ssserghei/xiao-wio-18650-tube-case/docs/images/battery_contacts.png

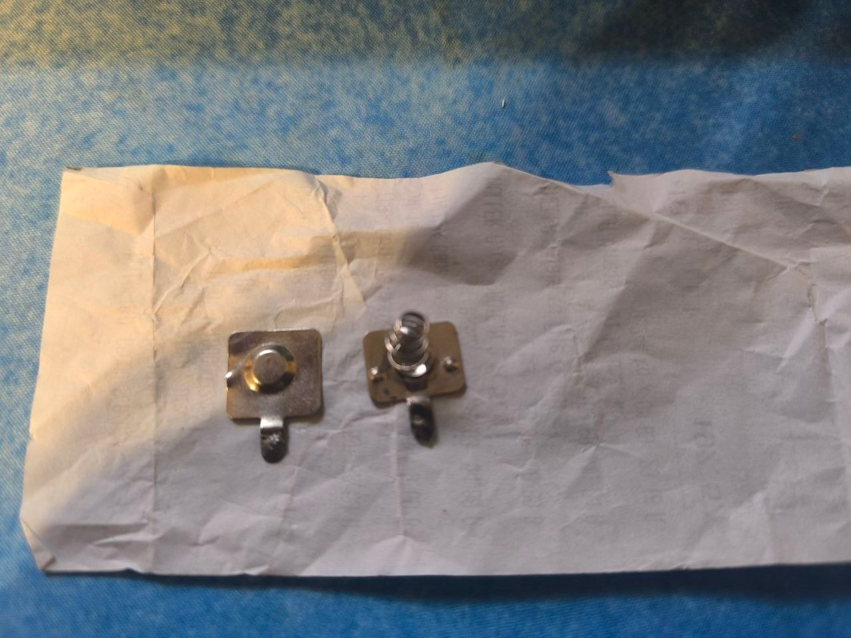
docs/images/battery_contacts.png
