ssserghei/xiao-wio-18650-tube-case/renders/rear_boards.png

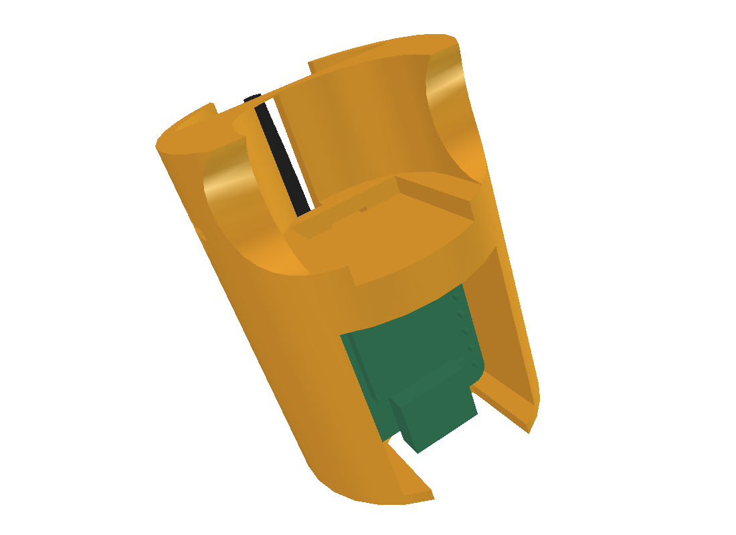
renders/rear_boards.png
