ssserghei/xiao-wio-18650-tube-case/renders/rear_boards_under.png

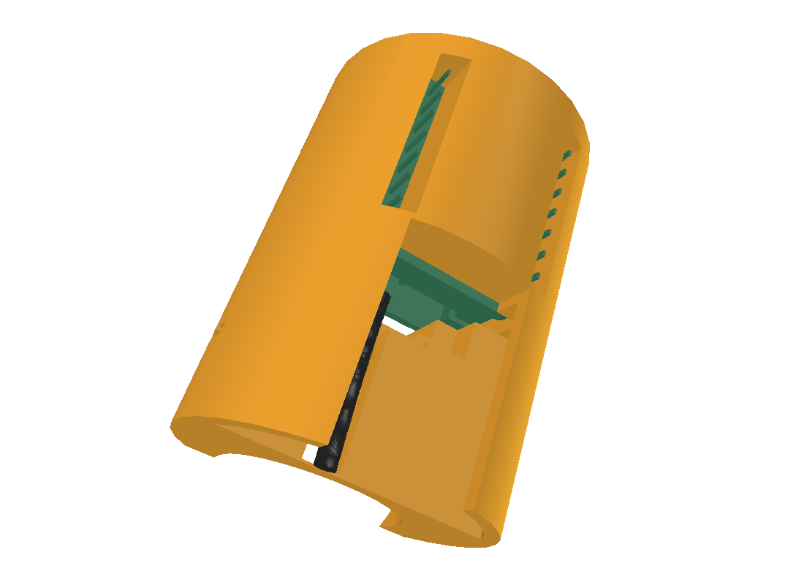
renders/rear_boards_under.png
