ssserghei/xiao-wio-18650-tube-case/renders/rear_iso_bottom.png

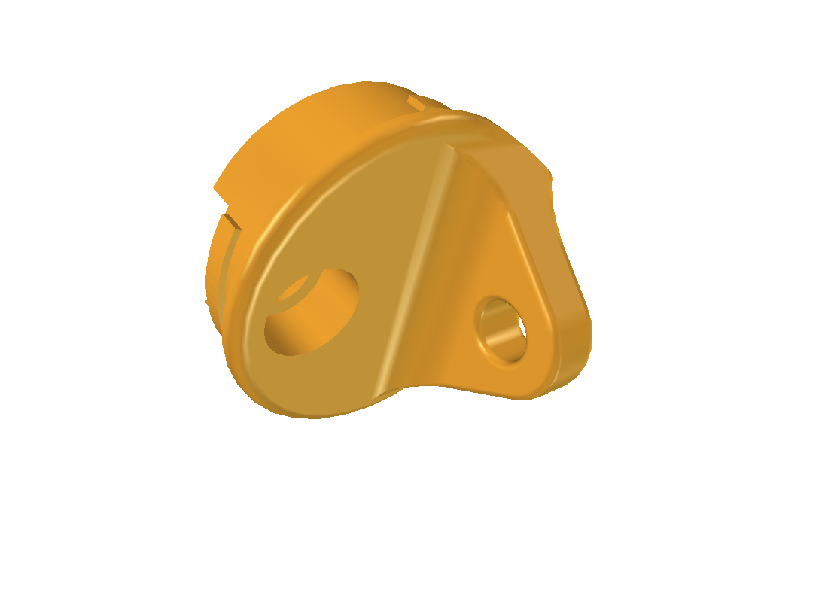
renders/rear_iso_bottom.png
