ssserghei/xiao-wio-18650-tube-case/renders/rear_rear.png

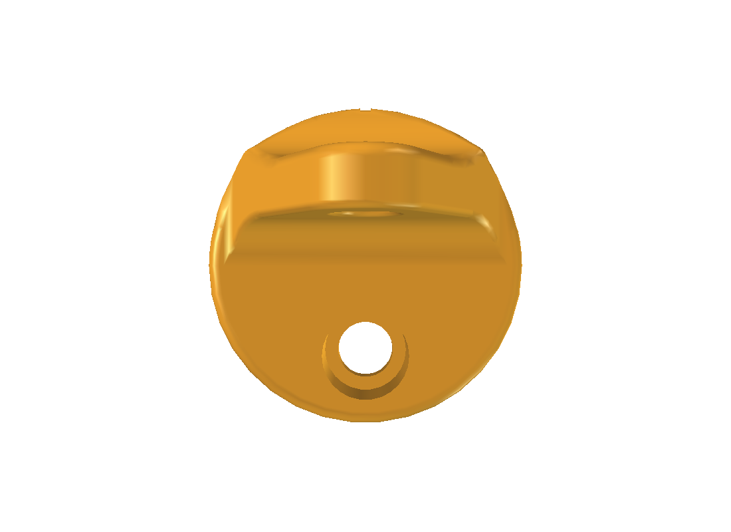
renders/rear_rear.png
