ssserghei/xiao-wio-18650-tube-case/renders/rear_side.png

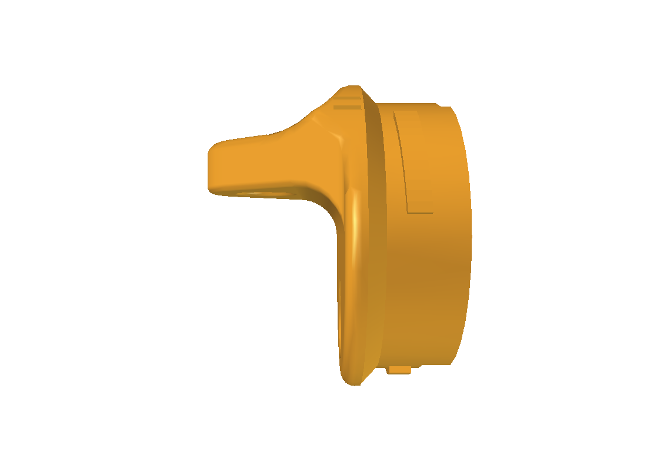
renders/rear_side.png
