ssserghei/xiao-wio-18650-tube-case/cad/xiao_wio_18650_tube_case.FCStd

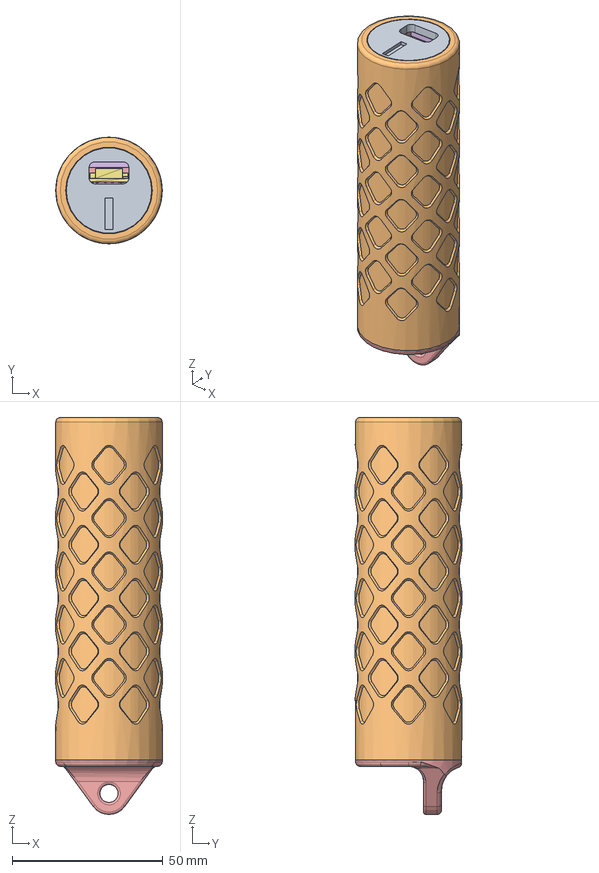
[picture p25: CAD file, 2026-11-11]
cad/xiao_wio_18650_tube_case.FCStd
35.4 x 35.4 x 131.9 mm
Battery
NegativeContact
PositiveContact
SpringEnvelope
ChassisFinal
BoardClamp
BoardStackModel
AntennaCable
Shutter
SleeveFinal
BatteryButton
