ssserghei/xiao-wio-18650-tube-case/reference/xiao-nrf52840-and-wio-sx1262.stl

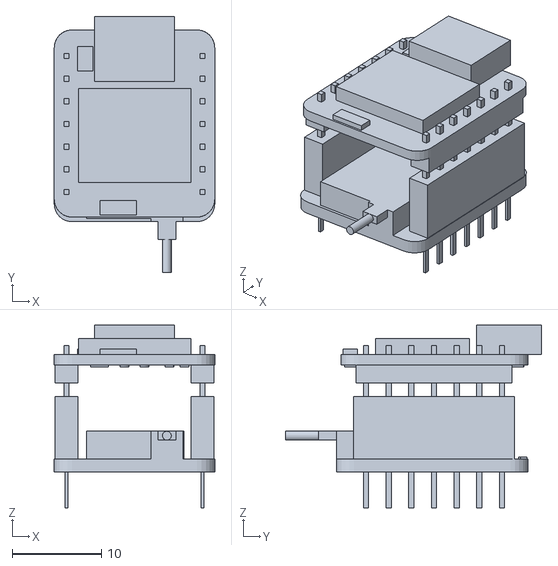
[picture p26: CAD file, 2026-11-07]
reference/xiao-nrf52840-and-wio-sx1262.stl
18.0 x 28.7 x 20.5
