ssserghei/xiao-wio-18650-tube-case/stl/xiao_wio_18650_tube_case_chassis.stl

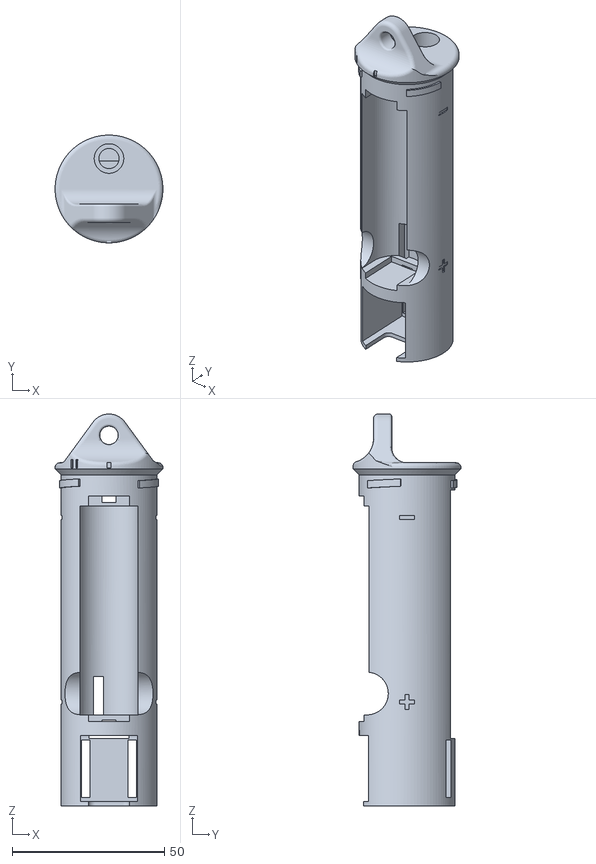
[picture p27: CAD file, 2026-11-11]
stl/xiao_wio_18650_tube_case_chassis.stl
35.4 x 35.4 x 128.7
