ssserghei/xiao-wio-18650-tube-case/stl/xiao_wio_18650_tube_case_sleeve.stl

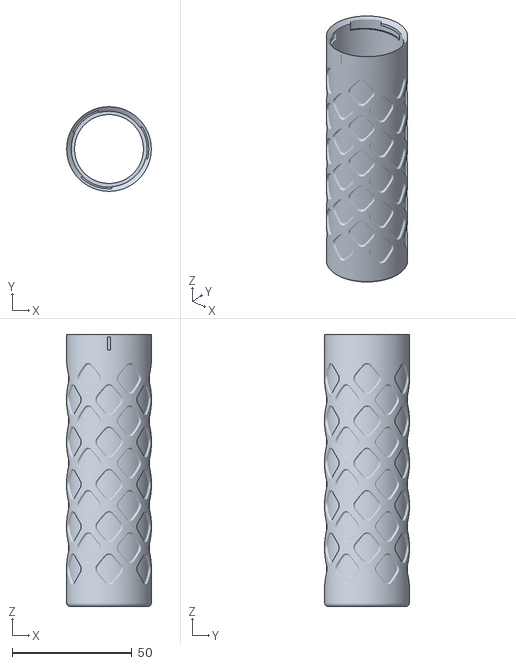
[picture p28: CAD file, 2026-11-11]
stl/xiao_wio_18650_tube_case_sleeve.stl
35.4 x 35.4 x 113.8
