ssserghei/xiao-wio-18650-tube-case/stl/xiao_wio_18650_tube_case_board_clamp.stl

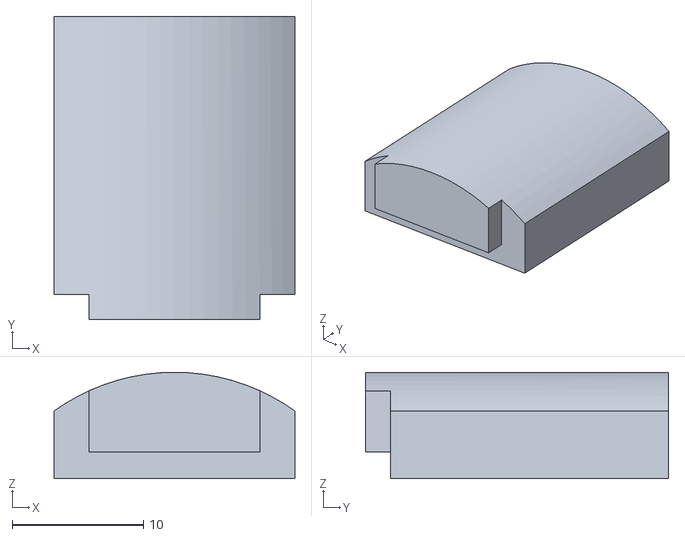
[picture p29: CAD file, 2026-11-10]
stl/xiao_wio_18650_tube_case_board_clamp.stl
18.3 x 23.0 x 8.10
