ssserghei/xiao-wio-18650-tube-case/stl/xiao_wio_18650_tube_case_shutter.stl

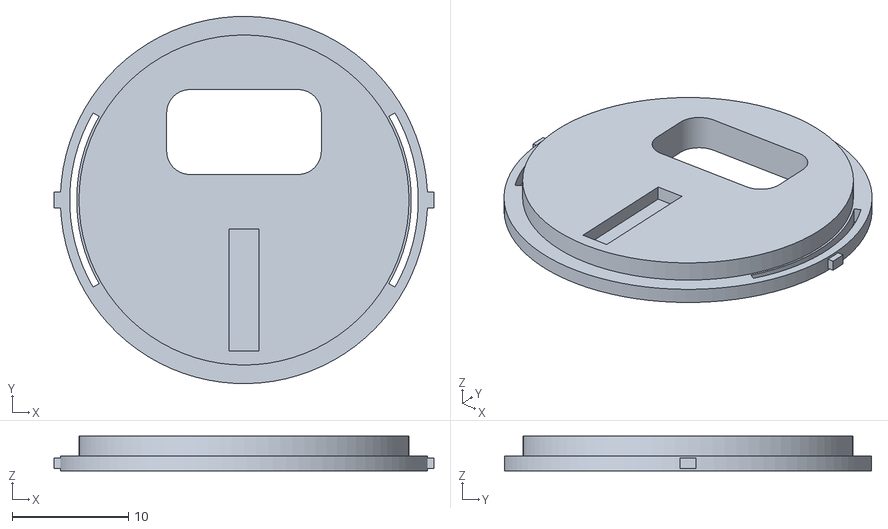
[picture p30: CAD file, 2026-11-10]
stl/xiao_wio_18650_tube_case_shutter.stl
32.7 x 31.6 x 3.00
