ssserghei/xiao-wio-18650-tube-case/TODO.md

# TODO

Changes planned after the first test print. See also *Things to check on the first print* in the [README](README.md).

## Other open items

- Print 3: check the shutter detents click, a reversed cell does not touch the plus plate, the USB-C plug seats fully, and the internal bridges of the standing chassis.
- Belt or backpack clip mount: on hold. Options: M3 pad under the flange, 25 mm strap loop on the flange, separate snap-on clip around the sleeve.
- Smaller diameter (about 32 mm): on hold, to discuss.
