ssserghei/xiao-wio-18650-tube-case/docs/design-log-ru.md

# Корпус XIAO + Wio: инструкция FreeCAD

**Сейчас: этап 35 — пробная печать и примерка.** Рабочий документ: `cad/xiao_wio_18650_tube_case.FCStd`; его правит Claude скриптами, `designs/xiao_wio_case/xiao_wio_case.FCStd` остаётся базой. Этапы 28–34 выполнены, этап 27 отменён. Интерфейс: FreeCAD 1.1.3, английский.
Вопросы задавай по номеру шага. Даём несколько этапов сразу; пояснения держим компактными.

## Дорожная карта до первого готового корпуса

| Этап | Результат |
| --- | --- |
| 25 | Размер и положение USB-C. |
| 26 | Проём USB-C в передней части шасси. |
| 27 | Отменён: выключателя нет, вставленная батарея сразу питает устройство. |
| 28 | Батарея поднята, проходы контактов, паз проводов снизу. Выполнен. |
| 29 | Подъём проводов к платам, отверстие антенного разъёма. Выполнен. |
| 30 | Поворотная шторка USB-C и окно под штекер. Выполнен. |
| 31 | Канавка кольца, ключ шасси — гильза, заход кольца. Выполнен. |
| 32 | Прижимная вставка плат. Выполнен. |
| 33 | Скруглённая проушина, отвод антенного кабеля, модель блока плат. Выполнен. Остальные скругления — после примерки. |
| 34 | STL всех деталей, проверка сетки и нарезка в PrusaSlicer. Выполнен. |
| 35 | Тестовая печать и примерка батареи, контактов, плат, антенны. |
| 36 | Корректировка размеров, финальный STL и печать корпуса. |

Ничего необратимого нет: после пробной примерки размеры можно спокойно менять в `Parameters`.

## Этап 22. Первый прототип держателей контактов

Цель простая: контактные пластины должны лежать на торцах батареи, а пружина — давить на аккумулятор. Сейчас не делаем точную фиксацию мелких выступов. Для первого прототипа оставим пластинам небольшой карман и проверим посадку физически.

- **22.1.** Больше ничего измерять сейчас не нужно. Уже известных размеров достаточно: пластины шириной 13 мм, минусовая — 10 мм высотой, плюсовая — 12,1 мм.
- **22.2.** Нажми **Ctrl+S**. На следующем шаге создадим по одному простому пазу под каждую пластину. Фиксирующие выступы и ушки добавим после первой примерки.

## Этап 23. Зазор для простых пазов

Пазы будут открыты в сторону большого бокового окна: пластину можно вставить до установки шасси в гильзу. Гильза закроет эти отверстия снаружи.

- **23.1.** В `Parameters` добавь три строки. Подпись — в A, значение — в B, alias назначь ячейке B.

| Строка | Подпись в A | Значение в B | Alias |
| --- | --- | --- | --- |
| 44 | Зазор паза контакта | `0.2 mm` | `ContactPocketClearance` |
| 45 | Глубина минусового паза | `=NegativePlateEnvelope + ContactPocketClearance` | `NegativePocketDepth` |
| 46 | Глубина плюсового паза | `=PositivePlateThickness + 2 * ContactPocketClearance` | `PositivePocketDepth` |

- **23.2.** Проверь: B45 = **1,1 мм**, B46 = **0,75 мм**. **Ctrl+S**.

## Этап 24. Вырезать два простых паза

- **24.1.** В 3D-виде оставь видимым `ChassisSpring`. Покажи `NegativeContact` и `PositiveContact`; им поставь **View → Transparency = 70**, чтобы видеть совпадение с пазами.
- **24.2.** Создай **Part → Primitives → Cube** → `NegativePocketTool`. Введи:

| Свойство | Выражение |
| --- | --- |
| Length | `<<Parameters>>.ContactPlateWidth + 2 * <<Parameters>>.ContactPocketClearance` |
| Width | `<<Parameters>>.ChassisDiameter / 2 + <<Parameters>>.NegativePlateHeight / 2 + <<Parameters>>.ContactPocketClearance + 1 mm` |
| Height | `<<Parameters>>.NegativePocketDepth` |
| Position x | `-(<<Parameters>>.ContactPlateWidth / 2 + <<Parameters>>.ContactPocketClearance)` |
| Position y | `-(<<Parameters>>.NegativePlateHeight / 2 + <<Parameters>>.ContactPocketClearance)` |
| Position z | `<<Parameters>>.NegativeContactZ - <<Parameters>>.NegativePocketDepth` |

- **24.3.** Выдели сначала `ChassisSpring`, затем с Ctrl `NegativePocketTool` → **Part → Boolean → Cut**. Назови результат `ChassisNegativePocket`.
- **24.4.** Создай второй **Cube** → `PositivePocketTool`. Введи:

| Свойство | Выражение |
| --- | --- |
| Length | `<<Parameters>>.ContactPlateWidth + 2 * <<Parameters>>.ContactPocketClearance` |
| Width | `<<Parameters>>.ChassisDiameter / 2 + <<Parameters>>.PositivePlateHeight / 2 + <<Parameters>>.ContactPocketClearance + 1 mm` |
| Height | `<<Parameters>>.PositivePocketDepth` |
| Position x | `-(<<Parameters>>.ContactPlateWidth / 2 + <<Parameters>>.ContactPocketClearance)` |
| Position y | `-(<<Parameters>>.PositivePlateHeight / 2 + <<Parameters>>.ContactPocketClearance)` |
| Position z | `<<Parameters>>.PositiveContactZ` |

- **24.5.** Выдели сначала `ChassisNegativePocket`, затем с Ctrl `PositivePocketTool` → **Part → Boolean → Cut**. Назови результат `ChassisContacts`.
- **24.6.** Выдели `ChassisContacts` → **Part → Check geometry → Run check**. Ожидаем **Solids = 1** и отсутствие ошибок. Временно поставь ему **Transparency = 80**: обе пластины должны лежать в пазах. **Ctrl+S**.

Пазы снаружи будут видны только до вставки шасси в гильзу. На первой примерке проверим, удерживает ли батарея пластины достаточно надёжно; тогда решим, нужны ли защёлки.

## Этап 25. Положение USB-C

Цель: получить три размера, чтобы сделать проём точно напротив разъёма. В FreeCAD пока ничего не меняем.

- **25.1.** Измерь ширину и высоту металлического USB-C разъёма.
- **25.2.** Измерь расстояние от центра USB-C до ближайшего края блока плат по вертикали.
- **25.3.** Пришли три значения в таком виде:

```text
USB-C: ширина … мм; высота … мм
Центр USB-C от ближайшего края блока плат: … мм
```

После этого сделаем прямоугольный проём с печатным зазором и привяжем к нему шторку.

## Этап 26. Макет проёма USB-C

Сначала ставим куб, который покажет будущую дырку. Его пока **не вырезаем**: `Electronics` — только габаритный блок, без точной формы разъёма.

**Ориентация зафиксирована:** сторона `+Y` — верх и сторона вставки «бутерброда» плат. USB-C выходит сюда же через открытый паз. Сторона `-Y` — низ: под батареей пойдёт антенный кабель.

- **26.1.** Перейди в **Part**. Скрой `Sleeve` и `ChassisContacts`. Покажи `Electronics`. Создай **Part → Primitives → Cube**, назови `USBWindowTool`.
- **26.2.** Во вкладке **Data** задай:

| Свойство | Значение |
| --- | --- |
| Length | `10 mm` |
| Width | `4.3 mm` |
| Height | `6 mm` |
| Position x | `-5 mm` |
| Position y | `<<Parameters>>.BoardThickness / 2 - 3.8 mm` |
| Position z | `<<Parameters>>.SleeveLength - <<Parameters>>.FrontSpace - 1 mm` |

10 × 4,3 мм — USB-C 9 × 3,3 мм плюс по 0,5 мм на сторону для печати. Куб должен лежать у верхнего края переднего торца блока плат; его ось совпадает с центром USB-C: 1,65 мм ниже верхней поверхности платы.

- **26.3.** Поставь `USBWindowTool` **View → Shape color** в яркий цвет и `Transparency = 40`. Нажми **0**, затем поверни модель к USB-торцу. Куб должен выходить за передний торец `Electronics` и находиться у его верхнего края.
- **26.4.** Скрой `Electronics`. Покажи `ChassisContacts`; `Sleeve` можно показать с прозрачностью 80. Выдели сначала `ChassisContacts`, затем с Ctrl `USBWindowTool` → **Part → Boolean → Cut**. Результат назови `ChassisUSB`.
- **26.5.** Выдели `ChassisUSB` → **Part → Check geometry → Run check**. Ожидаем `Solids = 1` и без ошибок. Покажи `Electronics`: USB-торец должен быть виден через новое отверстие. **Ctrl+S**.
- **26.6.** Проём должен быть открыт до верхнего края шасси, иначе «бутерброд» плат не вставится. Раскрой `ChassisUSB` в дереве и покажи `USBWindowTool` только для ориентира. Создай второй **Part → Primitives → Cube** → `USBEntryTool`.
- **26.7.** У `USBEntryTool` задай:

| Свойство | Значение |
| --- | --- |
| Length | `10 mm` |
| Width | `<<Parameters>>.ChassisDiameter / 2 - <<Parameters>>.BoardThickness / 2 + 1 mm` |
| Height | `6 mm` |
| Position x | `-5 mm` |
| Position y | `<<Parameters>>.BoardThickness / 2` |
| Position z | `<<Parameters>>.SleeveLength - <<Parameters>>.FrontSpace - 1 mm` |

Этот куб соединяет отверстие USB-C с верхним внешним краем. При текущих размерах его ширина будет **6,2 мм**.
- **26.8.** Выдели сначала `ChassisUSB`, затем с Ctrl `USBEntryTool` → **Part → Boolean → Cut**. Назови результат `ChassisUSBSlot`.
- **26.9.** Проверь `ChassisUSBSlot` через **Part → Check geometry**: `Solids = 1`, без ошибок. С USB-торца должен получиться открытый П-образный паз. **Ctrl+S**.

## Этап 35. Пробная печать и примерка

Детали лежат в `stl/`, уже в положении для печати; G-code для пробной печати — в `gcode/`. После правок модели оба набора устаревают. Настройки экспорта: FreeCAD 1.1.3, LinearDeflection 0,02 мм, AngularDeflection 10°, для шасси 0,05 мм и 12°, скрипт `scripts/export_stl.py`.

| Файл | Положение | Поддержки |
| --- | --- | --- |
| `xiao_wio_case_v2_chassis.stl` | лёжа, окном вверх: пазы контактов становятся вертикальными стенками | нужны, только от стола |
| `xiao_wio_case_v2_sleeve.stl` | стоя, бортиком на столе: нет свесов, отверстие круглое | не нужны |
| `xiao_wio_case_v2_board_clamp.stl` | плоской стороной на столе | не нужны, короткий свес у языка |
| `xiao_wio_case_v2_shutter.stl` | фланцем на столе: лицом вниз фланец висит в воздухе | не нужны |

Нарезка: PrusaSlicer 2.9.6, Creality Ender-3, сопло 0,4 мм, слой 0,2 мм, Generic PETG (240/70 °C), у шасси и гильзы кайма 6 мм. Сетки `manifold = yes`. Всего около 67 г и 8 ч 20 мин. Послойно смотрели только отдельные слои. Сначала стоит напечатать вставку и шторку: они быстрые и сразу покажут зазоры.

**Сборка**

1. Припаяй провода к ушкам контактов, заведи ушки в колодцы вниз и приклей пластины к плоским стенкам.
2. Заведи антенный разъём из паза изнутри, гайку наверни снаружи в выемке грибка. Выемка Ø12 мм, глубина 3,5 мм: нужна торцевая головка на 8 мм.
3. Проложи провода и антенный кабель по пазу и через подъём к платам. Припаяй провода, подключи антенну.
4. Вставь блок плат сверху, разъём USB-C попадает в окно торца. Сверху положи прижимную вставку, её язык закрывает паз над USB-C.
5. Надень кольцо 29 × 1,5 мм на канавку у грибка, вставь батарею: устройство сразу включится.
6. Вставь диск в гильзу с заднего конца до бортика. Вставь шасси USB-концом вперёд, совмести выступы с пазами и поверни шасси на 40° по часовой стрелке, если смотреть со стороны антенны, до затяжки.
7. Диск поворачивается за прорезь на торце. Открыто: окно напротив порта. Закрыто: поворот на 180°.

**Что проверить на примерке**

- Антенна накручивается до конца: резьба 11 мм, стенка 5,4 мм, гайка принята 2 мм, свободно около 3,6 мм. Глубже выемку делать нельзя: она прорежет грибок.
- Байонет: усилие затяжки и самоотвинчивание, крепость выступов. Кольцо 29 × 1,5 мм, канавка Ø29,6 × 2 мм.
- Передний упор блока плат: при выдёргивании штекера блок держат вставка и концы прорезей под штыри.
- Пружина минуса при рабочей высоте 2 мм: не сжимается ли она до упора.
- Диск: не слишком ли туго идёт, держат ли фиксаторы.
- Прижим плат вставкой: зазор 0,1 мм рассчитан по габаритному блоку.
- Проход проводов и антенного кабеля через подъём и выход за платами. Кабель Ø2 мм идёт практически прямо, до батареи около 1,2 мм.
- Посадку Wio на дно отсека и штыри в прорезях: прорезь 1,6 мм, кончики штырей на 0,5 мм от гильзы.
- Крепость проушины и размер отверстия Ø6 мм под твой карабин или шнур.

## Этап 33. Проушина, отвод кабеля, блок плат — выполнен

Скрипты: `apply_rear_lug.py`, `apply_cable_exit.py`, `apply_board_model.py`, `apply_lower_boards.py`, `apply_open_cable_slot.py`. Проверка: `check_stage_29_32.py`. Снимки: `renders/sections.png` и `renders/rear_*.png`.

- **Проушина** по образцу фото с Printables: плоская, плавно вырастает из торца через вогнутые дуги R5 и R8, контур сужается к концу Ø13 мм. Отверстие Ø6 мм смещено на 0,5 мм от конца, стенка у конца 4 мм, вылет 16 мм, толщина 6 мм, `LugCenterY` = 8 мм. Вместо `RearFlange` и кольца теперь одно тело `RearBody`. Диаметр грибка у гильзы остался полным. Рёбра скруглены R1,5 и R0,8; несколько коротких кромок у основания проушины FreeCAD не скруглил.
- **Блок плат** `BoardStackModel` — модель «XIAO nRF52840 & Wio-SX1262 Kit 3D model», автор zuberio, Printables, лицензия CC0. Только макет, не печатается. Высота 20,5 мм подтвердила замер 21 мм. Блок стоит в отсеке без касаний. В модели штыри на 0,35 мм короче реальных и кабель на 0,4 мм ниже, поэтому проверка считает штыри и кабель по замерам.
- **Спуск блока плат.** Изгиб кабеля мог сдёрнуть U.FL, поэтому блок опущен на 3 мм, штыри не подрезаем. Замеры: штыри 4,35 мм под Wio, центр кабеля 4,5 мм над низом Wio. Кончики штырей стоят на `PinTipY` = −13,5 мм, внутри диаметра шасси, и гильзы не касаются. Wio лежит на поднятом дне отсека (`WioBottomY` = −9,15 мм), штыри входят в прорези `PinSlotTools`. Верх блока теперь `StackTopY` = 7,5 мм, центр USB-C 5,85 мм, вставка стала толще, 8,1 мм.
- **Отвод кабеля.** U.FL стоит на верхней стороне Wio у конца, противоположного USB-C, кабель смещён на 3,6 мм от оси и выходит на Y=−4,65 мм. `BoardGap` = 6 мм. `CableExitTool` открывает выход на всю ширину паза, `CableSlotTool` — сквозной вырез 3,6 мм в полу батарейного отсека на последних 15 мм: стенка там не нужна, батарея лежит на боках ложемента. `AntennaCable` — макет кабеля, минимальный радиус изгиба 58 мм, то есть кабель практически прямой. Клип на U.FL между платами стоит оставить: он защищает от тряски.
- **STL.** На углах скруглений сетка получала мелкие самопересечения; `export_stl.py` чинит их и не записывает файл, пока сетка не чиста.

## Этап 45. Тонкая гильза — выполнено

Скрипт: `scripts/apply_thin_sleeve.py`. Гильза третьей печати оказалась слишком жёсткой. Стенка под решёткой 0,9 мм (две линии) вместо 1,5: `SleeveOuterDiameter` 33,8. Рёбра те же 0,8 мм, диаметр по рёбрам 35,4 вместо 36,6, грибок уменьшен следом, скругления заднего тела пересобраны. Пазы байонета и фиксаторов шторки лежат в сплошных поясах, над ними около 1 мм. Оболочка решётки теперь заходит в стенку только на 0,1 мм, иначе она снова заполняла бы эти пазы. Объём гильзы 16,1 см³ вместо 23,5.

Паутина внутри гильзы на печати — холостые переезды сопла поперёк трубы между участками заливки у рёбер. В PrusaSlicer: *Avoid crossing perimeters*, 5 периметров (вся стенка — круги), шов сзади, температура 235.

## Этап 44. Передняя стенка вплотную к платам — выполнено

Скрипт: `scripts/apply_trim_front.py`. Платы кончаются на 1,5 мм раньше разъёма USB-C (`USBOverhang`), и перед ними оставалась пустая полоса. Стенка 1,5 мм теперь стоит в 0,15 мм от плат, разъём проходит сквозь окно USB в ней, его торец на 0,15 мм не доходит до наружной плоскости стенки. `FrontSpace` 0,3 мм вместо 1,8: корпус на 1,5 мм короче (общая длина 131,9 мм), штекер входит на 1,5 мм глубже. Тело прижима кончается перед стенкой. Новая болванка `USBConnector`; путь штекера в проверке начинается от её торца.

## Этап 43. Утопление плюса по измеренной батарее — выполнено

Скрипт: `scripts/apply_measured_button.py`. Выступ плюса у батареи 1,32 мм (полная длина минус длина без выступа). При утоплении 0,5 мм выступ упирался бы в пластину раньше, чем плечо батареи в торец отсека: батарея встала бы на 0,8 мм дальше, и пружина распрямилась бы до ~3,3 мм.

- Отсек кончается у плеча батареи с зазором 0,3 мм (`BatteryPocketEndZ`).
- Кнопка пластины стоит ровно там, куда приходит выступ: на 1,02 мм за торцом отсека (`PlusContactRecess` = `BatteryButtonHeight` − `BatteryEndClearance`). Перевёрнутая батарея не достаёт до пластины на 1,02 мм.
- Пружина сохраняет рабочую высоту 2,5 мм. `BoardGap` снова 6 мм, корпус на 0,5 мм короче, чем на этапе 41.
- Болванка батареи теперь тело плюс выступ `BatteryButton` Ø8×1,32.
- Если батарея другая, поменяй `BatteryButtonHeight` и запусти `rebuild_static.py`.

## Этап 42. Крупнее фиксаторы шторки — выполнено

Скрипт: `scripts/apply_bold_detents.py`. Шторка держится подпружиненной защёлкой: выступ на тонкой дуге диска заскакивает в паз гильзы. На первой печати пазы глубиной 0,25 мм вышли похожими на паутинку от сопла и были срезаны. Теперь паз 0,75 мм глубиной (`DiscNotchRadius` 16,75) и 3 мм шириной (`DiscNotchWidth`), выступ диска 0,35 мм над посадкой (`DiscRibRadius` 16,35), пружинящая прорезь за выступом 0,6 мм (`DiscArcInnerRadius` 14,4).

## Этап 41. Защита от переполюсовки, метки, крупная решётка, печать стоя — выполнено

Скрипты: `scripts/apply_guard_marks.py`, `scripts/rebuild_static.py`.

- **Защита от переполюсовки.** Кнопка плюсовой пластины утоплена на 0,5 мм (`PlusContactRecess`) за торцевой стенкой отсека. Перед пластиной открытое окно 13,4 мм, а торец батареи Ø18,6 шире: перевёрнутая батарея упирается плоским минусом в стенку по краям окна и до пластины не достаёт, а выступ плюса входит в окно. Первый вариант с кольцом и отверстием Ø10 оставлял за кольцом паз 0,4 мм, который не напечатать; заменён скриптом `scripts/apply_open_plus_window.py`. Работает только с аккумулятором с выступом на плюсе (button top). Если 0,5 мм окажется мало, поменяй `PlusContactRecess` и запусти `rebuild_static.py`. Пластину вклеиваешь на заднюю стенку, как раньше.
- **Пружина минуса.** Отсек сдвинут на 0,5 мм от минусовой пластины (`RearSpace` 10,5): рабочая высота пружины 2,5 мм вместо 2, пластина осталась на месте. Плюсовая пластина ушла на +1,3 мм (Z=81,33), `BoardGap` 6,5 мм. Корпус длиннее на 1 мм.
- **Выемка под палец** радиусом 7 мм у плюсового конца батарейного окна, до оси батареи.
- **Метки.** «+» и «−» глубиной 0,5 мм на обеих боковинах шасси у контактов. На грибке одна канавка — положение «закрыто», две канавки — положение, в котором гильза надевается и снимается. На заднем поясе гильзы — риска, которая встаёт против канавок.
- **Решётка.** 6 ромбов по окружности вместо 11, рёбра 3 мм у основания, стенки ячеек с уклоном 30° (`RibDraft`), углы со скруглением 2,5 мм (`RibCornerRadius`). Только целые ячейки, без обрезков у поясов. Ячеек 60 вместо 231, решётка строится быстрее.
- **Печать стоя.** Шасси печатается на торце USB-C. Нижняя сторона грибка стала конусом 45° глубиной 1,9 мм (`SeamConeDepth`), гильза получила ответную юбку. Внутренние торцы отсеков и пазы пластин печатаются мостами до ~21 мм.
- **Параметричность.** `rebuild_static.py` пересобирает байонет, решётку, кабель, метки и скругления заднего тела по таблице. Скругления по рёбрам в FreeCAD хранятся номерами рёбер, поэтому «живыми» они не бывают: после правки таблицы запускай этот скрипт.

## Этап 40. Выпуклые рёбра вместо рифления — выполнено

Скрипт: `scripts/apply_raised_ribs.py`. Канавки рифления убраны: они утоньшали стенку. Вместо них на гильзу надета наружная оболочка 0,8 мм с ромбовидными окнами; между окнами остаются рёбра под 45°, 11 ромбов по окружности (около 10 мм), рёбра шириной 2,4 мм. Сплошные пояса: задний Z=0–6 мм над пазами байонета, где стенка теперь около 1,65 мм вместо 0,85, и передний 5,2 мм у торца. Диаметр по рёбрам 36,6 мм, грибок увеличен до того же диаметра, скругления заднего тела пересобраны. Построение окнами занимает около 1,5 минут; вариант с пересекающимися винтовыми рёбрами шёл 16 минут и дал некорректное тело.

## Этап 39. Ромбическое рифление на гильзе — выполнено

Скрипт: `scripts/apply_knurl.py`. Два пояса по 10 мм: задний на Z=6–16 мм, сразу за пазами байонета (над ними стенка всего 0,85 мм), передний на 10 мм перед торцом шасси, до пазов фиксаторов диска. 24 ромба по окружности (шаг около 4,6 мм), канавки V-образные глубиной 0,5 мм под 45°, у ромбов плоская вершина 0,6 мм. Склоны под 45° печатаются стоя без поддержек. Канавки — статическая форма `KnurlTool` из 96 винтовых вырезов. Проверка с рифлением идёт около 10 минут.

## Этап 38. Прорези под штыри для разъёмов Dupont — выполнен

Скрипт: `scripts/apply_dupont_slots.py`. Прорези под нижними штырями Wio расширены с 1,6 до 2,75 мм (`PinSlotWidth`), чтобы на штыри можно было надеть корпуса Dupont. Длина выросла с 17,3 до 18,8 мм (`PinSlotLength`): семь корпусов по 2,54 мм занимают около 17,8 мм. Ограничение по высоте: от низа Wio до гильзы около 6,8 мм, стандартный корпус Dupont (около 14 мм) туда не войдёт, нужен укороченный.

## Этап 37. Без кольца, крупный байонет, стенки ниши — выполнен

Скрипт: `scripts/apply_chunky_bayonet.py`.

- **Кольца нет.** Уплотнение было мнимым: напечатанный PETG пористый. Канавка убрана, задняя стенка Z=0…4,9 мм отдана байонету.
- **Байонет крупнее.** Выступы 2,4 мм толщиной вместо 1 мм и 45° шириной вместо 40°, подъём 0,5 мм за поворот 40°. Зазоры: 0,2 мм по оси и 0,25 мм по радиусу. Стенка гильзы над пазом 0,85 мм, опорная кромка 1,1–1,6 мм. Щелчка нет, держит затяжка.
- **Стенки ниши.** Ниша под батареей снова закрыта снаружи стенкой 1,5 мм (`WireNicheWall`), снизу открыт только прежний паз шириной 13 мм. Провода больше не вываливаются, когда надеваешь гильзу.
- **Заметки по скриптам.** Объединение двух винтовых лофтов паза молча теряет один из них, поэтому вырез получает их отдельными телами. Новая форма у `Part::Feature` не помечает зависимые объекты, их надо вызывать `touch()`. Сохранение иногда падает с «Permission denied», скрипт повторяет попытку.

## Этап 36. Правки после первой сборки — выполнены

Первый прототип собран, почти всё сошлось. Скрипт: `scripts/apply_antenna_niche.py`.

- **Стенка под антенну 2 мм** (`AntennaWallThickness`) между фланцем разъёма и гайкой, чтобы антенна накручивалась до конца. Свободной резьбы теперь около 7 мм.
- **Посадка основания антенны.** Основание Ø9,56 мм (`AntennaBaseDiameter`), выемка Ø9,71 мм: печатные отверстия выходят на 0,1–0,15 мм меньше, поэтому сядет туго. Выемка глубже, её дно на Z=1,9 мм; гайка стоит там же. Обычная головка на 8 мм в выемку не входит, нужен тонкостенный трубчатый ключ (наружный диаметр меньше 9,5 мм).
- **Шестигранник фланца разъёма** утоплен на 1 мм (`AntennaHexDepth`), карман 8,2 мм под ключ (`AntennaHexAcrossFlats`), гранями вверх и вниз: угол внизу почти доставал бы до канавки кольца. Допущение: фланец около 8 мм под ключ, как гайка.
- **Ниша для проводов на всю ширину.** Ниже потолка паза (`WireChannelTopY`) шасси открыто по всей ширине от задней стенки до отсека плат (`WireNicheTool`). Гильза закрывает нишу снаружи.
- **STL** не перевыгружались, они остались от первой печати.

## Этап 34. Гладкий корпус и открытые контакты — выполнен

Скрипты: `apply_flush_body.py`, `apply_open_contacts.py`, `apply_round_usb.py`, `apply_round_front.py`, `apply_strong_bayonet.py`. Проверка: `check_stage_29_32.py`.

- **Корпус.** `FlangeDiameter` равен диаметру гильзы, ступеней снаружи нет. Ключ, наружный выступ гильзы и старый колпачок удалены.
- **Байонет.** Винтовой: три выступа по 40° (около 11 мм) вместо 22°, подъём 0,4 мм за поворот 40°, в конце поворота грибок подтягивается к гильзе. Опорная кромка паза 0,75–1,15 мм, стенка гильзы над пазом 0,8 мм. Кольцо заменено на сечение 1,5 мм и сдвинуто на Z=2,4 мм, чтобы выступы встали перед ним и задняя стенка не удлинилась: иначе не хватит резьбы разъёма.
- **Передняя стенка у USB-C** 1,5 мм вместо 3,7 мм (`FrontSpace` = 1,8 мм): корпус на 2,2 мм короче, разъём ближе к торцу.
- **Диск.** Гильза длиннее шасси на 3,2 мм, спереди внутренний бортик. Диск `Shutter` вставляется изнутри, лицо заподлицо с торцом, поворот за прорезь, фиксаторы на пружинящих дугах входят в пазы гильзы.
- **Передний торец гильзы.** Наружная кромка скруглена R1,5.
- **Окна USB-C.** Углы скруглены R2: в диске все четыре, в шасси два нижних. Проверка рассчитана на штекер со скруглением корпуса R1; если у твоего углы острее, окно можно подпилить надфилем.
- **Контакты.** Всё между пластинами и батареей вырезано (`NegativeFaceTool`, `PositiveFaceTool`), пластины клеятся к плоским стенкам: минус Z=6,9 мм, плюс Z=80,43 мм. Минус перенесён на 2 мм к батарее: `SpringWorkingHeight` = 2 мм. `WireChannelStartZ` теперь задан числом, чтобы стенка разъёма не менялась. Колодцы 4,5 × 2,6 мм идут сквозь пол в паз проводов и пропускают разъём типа Dupont.

## Этапы 29–32. Антенна, шторка, кольцо, вставка — выполнены

Сделано скриптом `scripts/apply_stage_29_32.py`. Проверка: `scripts/check_stage_29_32.py`, разрезы: `renders/sections.png`. Четыре печатные детали — по одному корректному твёрдому телу, пересечений между собой и с макетами нет. Батарея, контакты, платы и вставка входят сверху, штекер 12,5 × 6,5 мм доходит до разъёма, шторка в закрытом положении полностью перекрывает порт. Это проверка по габаритным макетам, не физическая посадка.

Габариты корпуса: длина 132,9 мм вместе с проушиной, диаметр 35 мм.

- **Этап 29.** `BoardGap` увеличен до 6 мм, см. этап 33. Паз проводов расширен до 13 мм, чтобы провода шли мимо разъёма. `WireRiserTool` поднимает провода от паза к верхней плате. Разъём опущен к пазу: `AntennaCenterY` = −10 мм, отверстие Ø6,6 мм, выемка под гайку Ø12 × 3,5 мм. Минимальная стенка между отверстием и канавкой кольца 1,1 мм.
- **Этап 30.** Окно под литой корпус штекера 13,3 × 7,3 мм в торце шасси и в диске шторки. Шторка `Shutter` — колпачок на конце гильзы: диск 2,5 мм и упругая юбка с шестью прорезями. Защёлка заходит за кольцевой выступ гильзы, два ребра щёлкают в два паза. Фиксаторов два, через 180°: при 90° угол окна ещё заходит на порт.
- **Этап 31.** Канавка кольца Z=1,2…3,9 мм. Заход 0,5 мм на заднем конце гильзы, чтобы не срезать кольцо. `KeyTab` на грибке входит в наружный паз гильзы: шторка держится на гильзе, поэтому шасси не должно проворачиваться. Паз наружный, отверстие гильзы под кольцом остаётся целым.
- **Этап 32.** `BoardClamp` как в примере: заполняет проём над платами и повторяет цилиндр шасси, гильза прижимает её сверху. Язык закрывает паз над USB-C.

## Этап 28. Подъём батареи и паз проводов — выполнен

Сделано скриптом `scripts/apply_stage_28.py` в копии документа. Вручную повторять не нужно. Результат — `ChassisWireChannel`, новая вершина цепочки шасси.

- **Батарея поднята на 6,15 мм** (`BatteryCenterY`) по +Y: верх батареи на 0,25 мм ниже верха шасси (`BatteryTopGap`), Y=−3,15…15,45 мм. Над стенками ложемента она выступает примерно на 3 мм, так её удобно доставать. Контакты, пружина и все их пазы привязаны к той же оси.
- **Паз проводов** `WireChannelTool`: 10 мм шириной, открыт вниз, Y от −5,45 мм до наружной поверхности, Z=4,9…85 мм. Над ним перемычка 2 мм до полости батареи. Паз выходит в отсек плат; снизу его закрывает гильза.
- **Задний торец Z=0…4,9 мм оставлен целым**: на нём может стоять непрерывное уплотнение.
- **Исправлены две ошибки сборки.** `SpringEntryTool` открыл пружине путь сверху: раньше перемычка Z=6…9,7 мм не пускала пластину с пружиной в паз. `ButtonSlotTool` открыл кнопке плюса прорезь 8 мм: раньше стенка 0,43 мм отделяла её от батареи.
- **Проходы ушек** `NegativeTabPassTool` и `PositiveTabPassTool`: 4,5 × 2,2 мм, от пазов пластин вниз в паз проводов.

Проверка: `scripts/check_stage_28.py`, разрезы: `renders/sections.png`. Шасси — одно корректное твёрдое тело, пересечений с макетами нет, батарея, пластины, пружина и блок плат выходят вверх без помех, смена параметров пересчитывается. Это проверка по габаритным макетам, не физическая посадка.

На примерке проверить: стенку 0,43 мм перед плюсовой пластиной (вероятно слабое место печати), ширину прорези кнопки (8 мм принято по фото) и проход ушек с припаянным проводом.

## Этап 27. Выключатель — отменён

Выключателя в корпусе нет: вставленная батарея сразу питает устройство.

## Этап 19. Параметры батарейных контактов — выполнен

Минусовой контакт с пружиной размещаем со стороны антенны, плюсовой — со стороны плат. Пользователь проверил: пружина свободной высотой **6 мм** сжимается до **4 мм** без смыкания витков. Для первого прототипа принимаем рабочую высоту 4 мм; усилие прижима проверим при примерке.

- **19.1.** В `Parameters` добавь строки ниже: подпись в A, значение в B, alias назначь **ячейке B** через **ПКМ → Properties… → Alias**. Заполняй сверху вниз.

| Строка | Подпись в A | Значение в B | Alias |
| --- | --- | --- | --- |
| 31 | Ширина контактных пластин | `13 mm` | `ContactPlateWidth` |
| 32 | Высота плюсовой пластины | `12.1 mm` | `PositivePlateHeight` |
| 33 | Толщина плюсовой пластины | `0.35 mm` | `PositivePlateThickness` |
| 34 | Выступ кнопки плюсового контакта | `0.73 mm` | `PositiveButtonHeight` |
| 35 | Высота минусовой пластины | `10 mm` | `NegativePlateHeight` |
| 36 | Толщина металла минусовой пластины | `0.3 mm` | `NegativePlateThickness` |
| 37 | Габарит минусовой пластины с фиксатором | `0.9 mm` | `NegativePlateEnvelope` |
| 38 | Наружный диаметр пружины | `5.7 mm` | `SpringDiameter` |
| 39 | Свободная высота пружины | `6 mm` | `SpringFreeHeight` |
| 40 | Рабочая высота пружины | `4 mm` | `SpringWorkingHeight` |
| 41 | Радиальный зазор вокруг пружины | `0.3 mm` | `SpringClearance` |
| 42 | Лицевая плоскость минусовой пластины, Z | `=RearSpace - SpringWorkingHeight` | `NegativeContactZ` |
| 43 | Лицевая плоскость плюсовой пластины, Z | `=RearSpace + BatteryLength + PositiveButtonHeight` | `PositiveContactZ` |

Для минусового металла взяли верхнюю границу твоего замера **0,2–0,3 мм**. Габарит 0,9 мм учитывает фиксатор и понадобится для местного углубления.

- **19.2.** Проверь: **B42 = 6 mm**, **B43 = 80.03 mm**. Лицевая плоскость здесь — поверхность пластины, обращённая к батарее. **Ctrl+S**.

## Этап 20. Расставить макеты контактов — выполнен

Это отдельные вспомогательные объекты: их не объединяем с печатным шасси. Ушки, кнопка и фиксаторы пока не моделируются; цилиндр пружины обозначает занимаемое ею пространство.

- **20.1.** Перейди в 3D-вид, среду **Part**. Скрой `Sleeve` и `Electronics`, если они видны. У `ChassisLanyard` поставь **View → Transparency = 80**. Покажи `Battery`.
- **20.2.** **Part → Primitives → Cube** → **F2** → `NegativeContact`. Задай выражения через редактор `=`:

| Свойство | Выражение | Результат |
| --- | --- | --- |
| Length | `<<Parameters>>.ContactPlateWidth` | 13 мм |
| Width | `<<Parameters>>.NegativePlateHeight` | 10 мм |
| Height | `<<Parameters>>.NegativePlateThickness` | 0,3 мм |
| Position → x | `-<<Parameters>>.ContactPlateWidth / 2` | −6,5 мм |
| Position → y | `-<<Parameters>>.NegativePlateHeight / 2` | −5 мм |
| Position → z | `<<Parameters>>.NegativeContactZ - <<Parameters>>.NegativePlateThickness` | 5,7 мм |

Координаты находятся в **Placement → Position**. **Angle=0°**, Axis не меняем.

- **20.3.** Создай второй **Cube** → `PositiveContact`:

| Свойство | Выражение | Результат |
| --- | --- | --- |
| Length | `<<Parameters>>.ContactPlateWidth` | 13 мм |
| Width | `<<Parameters>>.PositivePlateHeight` | 12,1 мм |
| Height | `<<Parameters>>.PositivePlateThickness` | 0,35 мм |
| Position → x | `-<<Parameters>>.ContactPlateWidth / 2` | −6,5 мм |
| Position → y | `-<<Parameters>>.PositivePlateHeight / 2` | −6,05 мм |
| Position → z | `<<Parameters>>.PositiveContactZ` | 80,03 мм |

**Angle=0°**.

- **20.4.** **Part → Primitives → Cylinder** → `SpringEnvelope`. **Radius** = `<<Parameters>>.SpringDiameter / 2` (**2,85 мм**), **Height** = `<<Parameters>>.SpringWorkingHeight` (**4 мм**), **Position → z** = `<<Parameters>>.NegativeContactZ` (**6 мм**). Position x=y=0, Angle=0°.
- **20.5.** Проверь расположение: минусовая пластина Z=5,7…6 мм, пружина Z=6…10 мм, батарея Z=10…79,3 мм, плюсовая пластина Z=80,03…80,38 мм. Промежуток 0,73 мм перед плюсовой пластиной займёт её выпуклая кнопка. **Ctrl+S**.

Пересечения макетов пластин со шасси пока ожидаемы: пазы для них ещё не вырезаны.

## Этап 21. Сделать канал под пружину — выполнен

- **21.1.** Создай **Part → Primitives → Cylinder** → `SpringPocketTool`:

| Свойство | Выражение | Результат |
| --- | --- | --- |
| Radius | `<<Parameters>>.SpringDiameter / 2 + <<Parameters>>.SpringClearance` | 3,15 мм |
| Height | `<<Parameters>>.SpringWorkingHeight + 0.5 mm` | 4,5 мм |
| Position → z | `<<Parameters>>.NegativeContactZ` | 6 мм |

Position x=y=0, Angle=0°. Дополнительные 0,5 мм соединяют канал с полостью батареи.

- **21.2.** Сними выделение. Выдели **сначала `ChassisLanyard`**, затем с **Ctrl — `SpringPocketTool`** → **Part → Boolean → Cut**. Назови результат `ChassisSpring`. Проверь **Base = ChassisLanyard**, **Tool = SpringPocketTool**.
- **21.3.** У `ChassisSpring` поставь **View → Transparency = 80**. Макет `SpringEnvelope` должен находиться в новом канале. Канал расположен внутри задней перемычки; снаружи форма почти не изменится. Доступ к пластине откроем её посадочным пазом.
- **21.4.** Выдели `ChassisSpring` → **Part → Check geometry → Run check**: ожидаем отсутствие ошибок и **Solids = 1**. Закрой панель проверки. **Ctrl+S**.

Формулы и вырез проверены в FreeCAD 1.1.3 на модели в памяти: одно корректное твёрдое тело, канал свободен для макета пружины. Пазы пластин, выходы под ушки и местные углубления фиксаторов остаются следующим узлом.

## Этап 16. Параметры ушка — выполнен

Ушко расположим у края грибка с его наружной стороны, за плоскостью **Z=−4 мм**. Отверстие направлено поперёк корпуса, вдоль Y. Центр грибка оставляем под антенный разъём; совместимость с его гайкой и антенной проверим по их размерам.

- **16.1.** В `Parameters` добавь строки: подпись в A, значение в B, alias назначь **ячейке B** через **ПКМ → Properties… → Alias**.

| Строка | Подпись в A | Значение в B | Alias |
| --- | --- | --- | --- |
| 26 | Наружный диаметр ушка | `12 mm` | `LoopOuterDiameter` |
| 27 | Диаметр отверстия темляка | `5 mm` | `LoopHoleDiameter` |
| 28 | Толщина ушка | `6 mm` | `LoopThickness` |
| 29 | Заход ушка в грибок | `2 mm` | `LoopOverlap` |
| 30 | Отступ ушка от края по X | `0.5 mm` | `LoopEdgeInset` |

- **16.2.** **Ctrl+S**. Эти размеры задают начальную форму; прочность ушка и проход конкретного шнурка проверим на пробной печати.

## Этап 17. Создать и повернуть ушко — выполнен

- **17.1.** Перейди в 3D-вид, среду **Part**. Оставь видимым `ChassisPockets`; скрой `Battery`, `Electronics`, `Sleeve`, если они показаны. **Part → Primitives → Tube** → **OK** → **F2** → `LanyardLoop`.
- **17.2.** Задай выражения через **двойной щелчок по значению → `=` → выражение → OK**. Начальный знак `=` в редакторе не вводи.

| Свойство | Выражение | Результат |
| --- | --- | --- |
| Outer Radius | `<<Parameters>>.LoopOuterDiameter / 2` | 6 мм |
| Inner Radius | `<<Parameters>>.LoopHoleDiameter / 2` | 2,5 мм |
| Height | `<<Parameters>>.LoopThickness` | 6 мм |

- **17.3.** В **Data → Placement** задай **Angle = 90°**. Затем раскрой **Axis** и последовательно поставь **x=1, y=0, z=0**. Здесь намеренно меняем **Axis**, чтобы повернуть кольцо. Проверь итог: **Axis = [1, 0, 0]**, **Angle = 90°**.
- **17.4.** Теперь в **Placement → Position** задай выражения:

| Координата | Выражение | Результат |
| --- | --- | --- |
| x | `<<Parameters>>.FlangeDiameter / 2 - <<Parameters>>.LoopOuterDiameter / 2 - <<Parameters>>.LoopEdgeInset` | 12 мм |
| y | `<<Parameters>>.LoopThickness / 2` | 3 мм |
| z | `-<<Parameters>>.FlangeThickness - <<Parameters>>.LoopOuterDiameter / 2 + <<Parameters>>.LoopOverlap` | −8 мм |

- **17.5.** **View → Standard views → Rear**, затем **Fit all**. Кольцо должно стоять ребром на внешней стороне грибка у его края. Верх кольца заходит в грибок на **2 мм**, отверстие остаётся открытым. Кольцо занимает **Z=−14…−2 мм**. **Ctrl+S**.

## Этап 18. Объединить ушко с шасси — выполнен

- **18.1.** Сними выделение. Выдели в дереве `ChassisPockets`, затем с **Ctrl** — `LanyardLoop` → **Part → Boolean → Union**. Результат назови `ChassisLanyard`.
- **18.2.** У результата поставь **View → Transparency = 0**. Исходные объекты останутся внутри него в дереве; оставь их скрытыми. Нажми **0** для аксонометрии. Ушко должно быть соединено с грибком, а отверстие — сквозным.
- **18.3.** Выдели `ChassisLanyard` целиком → **Part → Check geometry → Run check**. Ожидаем отсутствие ошибок и **Solids = 1** в **Shape Content**. Закрой панель проверки.
- **18.4.** Покажи `Sleeve` с **Transparency = 80**. Ушко находится за грибком и не входит в гильзу. **Ctrl+S**.

Форма проверена в FreeCAD 1.1.3 на модели в памяти: шасси с ушком — одно корректное твёрдое тело, отверстие открыто, пересечений с гильзой и макетами компонентов нет. Эта проверка не определяет прочность напечатанного ушка.

## Этап 13. Параметры полости плат — выполнен

- **13.1.** Нажми **Ctrl+S**. Звёздочка возле имени документа должна исчезнуть.
- **13.2.** Раскрой `ChassisBattery` в дереве, выдели `BatteryWindowTool`. В **Data → Placement → Position → x** задай выражение `-<<Parameters>>.BatteryPocketDiameter / 2`. Сейчас −9,6 мм выставлено числом; формула сохранит центрирование при изменении диаметра батареи. Размеры модели пока не изменятся.
- **13.3.** В `Parameters` добавь строки: подпись в A, значение в B, alias назначь **ячейке B** через **ПКМ → Properties… → Alias**. Вводи сверху вниз.

| Строка | Подпись в A | Значение в B | Alias |
| --- | --- | --- | --- |
| 22 | Зазор вокруг блока плат, на сторону | `0.3 mm` | `BoardClearance` |
| 23 | Ширина полости плат, X | `=BoardWidth + 2 * BoardClearance` | `BoardPocketWidth` |
| 24 | Длина полости плат, Z | `=BoardLength + 2 * BoardClearance` | `BoardPocketLength` |
| 25 | Начало полости плат, Z | `=RearSpace + BatteryLength + BoardGap - BoardClearance` | `BoardPocketStart` |

- **13.4.** Проверь: **B23 = 18.6 mm**, **B24 = 23.2 mm**, **B25 = 84 mm**. **Ctrl+S**.

## Этап 14. Вырезать открытое посадочное место плат — выполнен

Окно открываем в сторону **+Y**, как у батареи. Пока создаём пространство под комплект плат; опоры и фиксацию плат добавим отдельно. Разъём USB-C ориентируем к переднему торцу, в сторону **+Z**.

- **14.1.** Перейди в 3D-вид, среду **Part**. Оставь видимым `ChassisBattery`; скрой `Sleeve`, `Battery`, `Electronics`, если они показаны. **Part → Primitives → Cube** → **F2** → `BoardPocketTool`.
- **14.2.** В свойствах куба задавай выражения через **двойной щелчок → `=` → выражение → OK**, без начального `=`:

| Свойство | Выражение | Результат |
| --- | --- | --- |
| Length | `<<Parameters>>.BoardPocketWidth` | 18,6 мм |
| Width | `<<Parameters>>.ChassisDiameter / 2 + <<Parameters>>.BoardThickness / 2 + <<Parameters>>.BoardClearance + 1 mm` | 27,5 мм |
| Height | `<<Parameters>>.BoardPocketLength` | 23,2 мм |

Большая **Width** выводит инструмент за поверхность шасси и открывает полость сбоку.

- **14.3.** В **Placement → Position** установи:

| Координата | Выражение | Результат |
| --- | --- | --- |
| x | `-<<Parameters>>.BoardPocketWidth / 2` | −9,3 мм |
| y | `-<<Parameters>>.BoardThickness / 2 - <<Parameters>>.BoardClearance` | −10,8 мм |
| z | `<<Parameters>>.BoardPocketStart` | 84 мм |

**Angle=0°**. Не меняй **Axis**.

- **14.4.** Сними выделение. Выдели **сначала `ChassisBattery`**, затем с **Ctrl — `BoardPocketTool`** → **Part → Boolean → Cut**. Результат назови `ChassisPockets`. Проверь в **Data**: **Base = ChassisBattery**, **Tool = BoardPocketTool**.
- **14.5.** Поставь **View → Transparency = 0**. Выбери **View → Standard views → Rear**, затем **Fit all**. Теперь видны два окна: длинное под батарею и короткое под платы. Между окнами остаётся перемычка **4,4 мм**, перед полостью плат — торец толщиной **3,7 мм**.
- **14.6.** Покажи `Battery` и `Electronics` через **Пробел**: каждый макет должен находиться в своей полости. Нажми **0** для аксонометрии. При необходимости покажи `Sleeve` с **Transparency = 80**. **Ctrl+S**.

Передний торец пока закрыт: отверстия USB-C и механизм шторки сделаем после уточнения положения разъёма. Макет `Electronics` обозначает габарит всего комплекта, поэтому по нему ещё нельзя разместить точные опоры под сами платы.

## Этап 15. Проверить геометрию и пересчёт — выполнен

- **15.1.** Выдели **`ChassisPockets` целиком в дереве** → **Part → Check geometry**. Если открылись настройки, нажми **Run check**. Ожидаем отсутствие ошибок; в **Shape Content** должно быть **Solids = 1**. Закрой панель проверки.
- **15.2.** В `Parameters` временно поставь **B3 = `70.3 mm`**. Проверь: **B14 = 111.9 mm**, **B25 = 85 mm**; у `Electronics` координата **Position → z = 85.3 mm**. Оба окна должны перестроиться вместе с компоновкой.
- **15.3.** Верни **B3 = `69.3 mm`**. Длина гильзы снова **110,9 мм**, начало полости плат **84 мм**. Если необходимо, нажми **F5**.
- **15.4.** **Ctrl+S**. Результат: цельное шасси с двумя открытыми посадочными местами. Готовность к печати проверим после добавления креплений и остальных элементов.

Этот блок проверен в FreeCAD 1.1.3 на модели в памяти: одно корректное твёрдое тело, пересечений с макетами батареи, плат и гильзой нет; изменение длины батареи пересчитывает полость плат. Проверки относятся к габаритным макетам, не к физической сборке.

## Этап 10. Перенести замеры и увеличить внутренний диаметр — выполнен

Поперечный габарит плат **18 × 21 мм** имеет диагональ **27,66 мм** — больше прежнего шасси Ø27,4 мм. Принимаем гильзу **Ø35/32 мм**, шасси **Ø31,4 мм**: стенка гильзы получится **1,5 мм**. Это рабочие размеры для прототипа; прочность и посадку проверим печатью. Блок плат считаем по указанным замерам, включая Y=21 мм.

- **10.1.** Открой `Parameters`. Замени **только значения** в следующих ячейках; их alias сохрани:

| Ячейка | Alias | Новое значение |
| --- | --- | --- |
| B2 | BatteryDiameter | `18.6 mm` |
| B3 | BatteryLength | `69.3 mm` |
| B6 | BoardWidth | `18 mm` |
| B7 | BoardThickness | `21 mm` |
| B8 | BoardLength | `22.6 mm` |
| B12 | SleeveInnerDiameter | `32 mm` |

- **10.2.** Проверь: **B14 = 110.9 mm**, **B15 = 31.4 mm**. Батарея начинается на Z=10 мм и заканчивается на Z=79,3 мм; блок плат начинается на Z=84,3 мм. Промежуток остаётся 5 мм.
- **10.3.** Добавь строки ниже: подпись в A, значение в B, alias назначь **ячейке B** через **ПКМ → Properties… → Alias**. Вводи сверху вниз.

| Строка | Подпись в A | Значение в B | Alias |
| --- | --- | --- | --- |
| 18 | Зазор вокруг батареи, на сторону | `0.3 mm` | `BatteryClearance` |
| 19 | Торцевой зазор батареи, на сторону | `0.3 mm` | `BatteryEndClearance` |
| 20 | Диаметр полости батареи | `=BatteryDiameter + 2 * BatteryClearance` | `BatteryPocketDiameter` |
| 21 | Длина полости батареи | `=BatteryLength + 2 * BatteryEndClearance` | `BatteryPocketLength` |

- **10.4.** Проверь: **B20 = 19.2 mm**, **B21 = 69.9 mm**. Зазоры — начальные для пробной печати; торцевой зазор не задаёт поджатие пружины. **Ctrl+S**.

## Этап 11. Вырезать цилиндрическую полость — выполнен

Формулы свойств: **двойной щелчок по значению → `=` → выражение → OK**, без начального `=`. Координаты меняем в **Placement → Position**, не в **Axis**.

- **11.1.** Перейди в 3D-вид, среду **Part**. Скрой `Sleeve`, `Battery`, `Electronics` через **Пробел**, если они видны. У видимого `ChassisBlank` установи **View → Transparency = 0**.
- **11.2.** **Part → Primitives → Cylinder** → **F2** → `BatteryPocketTool`. Это вспомогательное тело для вырезания, не макет батареи.
- **11.3.** Задай свойства нового цилиндра:

| Свойство | Выражение | Результат |
| --- | --- | --- |
| Radius | `<<Parameters>>.BatteryPocketDiameter / 2` | 9,6 мм |
| Height | `<<Parameters>>.BatteryPocketLength` | 69,9 мм |
| Placement → Position → z | `<<Parameters>>.RearSpace - <<Parameters>>.BatteryEndClearance` | 9,7 мм |

Оставь **Position x=y=0**, **Angle=0°**.

- **11.4.** Сними выделение. Выдели в дереве **сначала `ChassisBlank`**, затем с **Ctrl — `BatteryPocketTool`** → **Part → Boolean → Cut**. Переименуй результат в `ChassisBore`.
- **11.5.** В его **Data** проверь: **Base = ChassisBlank**, **Tool = BatteryPocketTool**. Исходные объекты находятся внутри результата в дереве; оставь их скрытыми. Полость пока закрыта снаружи — это ожидаемо. **Ctrl+S**.

## Этап 12. Открыть доступ к батарее сбоку — выполнен

Окно будет обращено в сторону **+Y**. Скруглённая задняя часть ложемента и торцевые перемычки останутся.

- **12.1.** **Part → Primitives → Cube** → **F2** → `BatteryWindowTool`.
- **12.2.** Задай размеры:

| Свойство | Выражение | Результат |
| --- | --- | --- |
| Length | `<<Parameters>>.BatteryPocketDiameter` | 19,2 мм |
| Width | `<<Parameters>>.ChassisDiameter / 2 + 1 mm` | 16,7 мм |
| Height | `<<Parameters>>.BatteryPocketLength` | 69,9 мм |

Дополнительный 1 мм выводит инструмент за наружную поверхность шасси.

- **12.3.** В **Placement → Position** установи:

| Координата | Значение/выражение | Результат |
| --- | --- | --- |
| x | `-<<Parameters>>.BatteryPocketDiameter / 2` | −9,6 мм |
| y | `0 mm` | 0 мм |
| z | `<<Parameters>>.RearSpace - <<Parameters>>.BatteryEndClearance` | 9,7 мм |

**Angle=0°**.

- **12.4.** Сними выделение. Выдели **сначала `ChassisBore`**, затем с **Ctrl — `BatteryWindowTool`** → **Part → Boolean → Cut**. Результат назови `ChassisBattery`. Проверь **Base = ChassisBore**, **Tool = BatteryWindowTool**.
- **12.5.** У `ChassisBattery` поставь **View → Transparency = 0**. Выбери **View → Standard views → Rear**, затем **Fit all** в том же меню. Должно быть видно продольное окно шириной **19,2 мм**, высотой **69,9 мм**, со скруглённым ложементом внутри. Другие объекты пока скрыты.
- **12.6.** Покажи `Battery` через **Пробел**: она должна лежать в окне с зазором. Нажми **0** для аксонометрии. Покажи `Sleeve`, сохрани её **Transparency = 80**. Батарея вставляется сбоку после извлечения шасси из гильзы.
- **12.7.** **Ctrl+S**. Результат: гильза, шасси с грибком и открытым ложементом батареи. Макет `Electronics` остаётся в дереве, пока скрыт. Посадка плат, держатели контактов, уплотнения и шторка ещё впереди.

Формулы и два выреза проверены в FreeCAD 1.1.3 на копии модели в памяти: результат — одно корректное твёрдое тело, пересечений с макетом батареи нет. Физическая посадка ещё не проверена. Для пазов контактов дальше уточним рабочую высоту пружины и направление ушек 3 × 5,7 мм.

## Пройденные этапы

Ниже сохранена история шагов. Размеры в этапах 1–8 относятся к прежней компоновке; актуальные значения заданы в этапе 10. Повторять прежние значения не нужно.

## Поправка после этапа 8. Положение батареи — выполнена

Ранее у `Battery` выражение `RearSpace` оказалось в **Placement → Axis → z** — это направление оси вращения. Исправлено: теперь **Placement → Position → z = 10 mm**.

- **8.5.** Выдели `Battery` → **Data → Placement**. Раскрой **Axis** и **Position**: это два разных пункта.
- **8.6.** В **Axis → z** открой редактор выражения через `=`. Замени выражение на просто `1` → **OK**. Для Axis оставь x=0, y=0; **Angle = 0°**.
- **8.7.** Теперь в **Position → z** задай выражение `<<Parameters>>.RearSpace` → **OK**. Здесь результат должен быть **10 mm**; Position x=y=0.
- **8.8.** Батарея должна занимать Z=10…75 мм, платы начинаться на Z=80 мм. Промежуток — **5 мм**. Нажми **Ctrl+S**.

## Этап 9. Размеры для посадочных мест — выполнен

Подготовь размеры ниже в миллиметрах. Если детали пока нет, отметь «нет» — её посадку оставим предварительной.

- **9.1. Аккумулятор.** Измерь наружный диаметр с оболочкой и полную длину. Для измерения длины используй пластиковый инструмент: металлические губки не должны соединять полюса.
- **9.2. Комплект плат.** Собери XIAO и Wio в рабочем положении. Запиши ширину поперёк платы (**X**), общую толщину с компонентами (**Y**), длину в направлении USB (**Z**, включая выступающий разъём). Сейчас в модели стоят условные 20 × 12 × 24 мм.
- **9.3. Контакты.** Для каждой пластины запиши ширину, высоту и толщину; отдельно выступ контактной кнопки, свободную высоту и диаметр пружины. Ушки для пайки учитывай отдельно. Не сжимай пружину до упора.
- **9.4.** Передай размеры по шаблону ниже. После проверки перенесём их в таблицу и построим полость с боковым доступом к батарее. Размеры контактов определят торцевые опоры.

```text
18650: диаметр 18.6; длина 69.3
Комплект плат: X 18; Y 21; Z 22.6
Плюсовой контакт: пластина Ш×В×Т 13x12.1x0.35; выступ кнопки 0.73
Минусовой контакт: пластина Ш×В 13x10; металл 0.2–0.3; габарит с фиксирующим выступом 0.9; пружина высота 6, диаметр 5.7
Ушки контактов: размеры и направление Ш×В: 3x5.7
```

### Форма контактов по фотографии

[Фото контактов](images/battery_contacts.png).

- Слева — пластина с выпуклой кнопкой для плюса, справа — пластина с пружиной для минуса. На нижнем краю каждой есть ушко для пайки.
- На пластинах видны небольшие штампованные выступы. Для посадки предусмотрим опору по краям пластин, свободное место под выступы и отдельный выход для ушка с проводом.
- Уточнено пользователем: у минусового контакта металл **0,2–0,3 мм**, общий габарит с фиксирующим выступом **0,9 мм**. Паз для края пластины рассчитываем по толщине металла с припуском на печать; для фиксатора предусматриваем местное углубление.
- Перед точными посадками остаётся определить расположение и размеры фиксирующих выступов и изгиб ушек. Для пружины принята начальная рабочая высота **4 мм**: пользователь подтвердил сжатие до неё без смыкания витков; усилие ещё нужно проверить при примерке.

## Этап 4. Параметры общей компоновки

Ось **Z** направлена от антенны к USB. Гильза занимает Z=0…108 мм, «грибок» — Z=−4…0 мм. Пока строим заготовки: размеры батареи, плат и технологические зазоры предварительные. Блок плат 20 × 12 × 24 мм — выбранный макет, не размер из документации производителя.

- **4.1.** Открой `Parameters`. Добавь строки ниже: подпись в **A**, значение в **B**, alias назначь **ячейке B** через **ПКМ → Properties… → Alias**. Делай сверху вниз: значение → alias → следующая строка. Столбец C можно использовать для памятки.

| Строка | Подпись в A | Значение/формула в B | Alias ячейки B |
| --- | --- | --- | --- |
| 5 | Место за батареей | `10 mm` | `RearSpace` |
| 6 | Ширина блока плат, X | `20 mm` | `BoardWidth` |
| 7 | Толщина блока плат, Y | `12 mm` | `BoardThickness` |
| 8 | Длина блока плат, Z | `24 mm` | `BoardLength` |
| 9 | Промежуток батарея — платы | `5 mm` | `BoardGap` |
| 10 | Место перед платами | `4 mm` | `FrontSpace` |
| 11 | Наружный диаметр гильзы | `35 mm` | `SleeveOuterDiameter` |
| 12 | Внутренний диаметр гильзы | `28 mm` | `SleeveInnerDiameter` |
| 13 | Радиальный зазор шасси | `0.3 mm` | `RadialGap` |
| 14 | Длина гильзы | `=RearSpace + BatteryLength + BoardGap + BoardLength + FrontSpace` | `SleeveLength` |
| 15 | Диаметр шасси | `=SleeveInnerDiameter - 2 * RadialGap` | `ChassisDiameter` |
| 16 | Толщина грибка | `4 mm` | `FlangeThickness` |
| 17 | Диаметр грибка | `=SleeveOuterDiameter + 2 mm` | `FlangeDiameter` |

- **4.2.** Проверь вычисления: **B14 = 108 mm**, **B15 = 27.4 mm**, **B17 = 37 mm**. Зазор 0,3 мм задан **на сторону**, по диаметру получается 0,6 мм. Нажми **Ctrl+S**.

## Этап 5. Расставить батарею и платы

Дальше формулы задаём в свойствах через **двойной щелчок по значению → клавиша `=` → выражение → OK**. В этом редакторе начальный знак `=` не вводим. Координаты находятся в **Data → Placement → Position**: раскрой пункты стрелками слева.

- **5.1.** Перейди в 3D-вид и среду **Part**. Выдели `Battery`. Для **Placement → Position → z** задай `<<Parameters>>.RearSpace`. Выбирай **Position**, не соседний **Axis**. X и Y оставь нулевыми. Батарея теперь занимает Z=10…75 мм.
- **5.2.** **Part → Primitives → Cube**. Переименуй созданный объект через **F2** в `Electronics`.
- **5.3.** В **Data** свяжи размеры блока с таблицей:

| Свойство | Выражение |
| --- | --- |
| Length — размер по X | `<<Parameters>>.BoardWidth` |
| Width — размер по Y | `<<Parameters>>.BoardThickness` |
| Height — размер по Z | `<<Parameters>>.BoardLength` |

- **5.4.** В **Placement → Position** задай:

| Координата | Выражение | Сейчас |
| --- | --- | --- |
| x | `-<<Parameters>>.BoardWidth / 2` | −10 мм |
| y | `-<<Parameters>>.BoardThickness / 2` | −6 мм |
| z | `<<Parameters>>.RearSpace + <<Parameters>>.BatteryLength + <<Parameters>>.BoardGap` | 80 мм |

- **5.5.** Щёлкни по 3D-виду → **0** → **View → Standard views → Fit all**. Блок должен стоять над батареей с промежутком **5 мм**, его верх — Z=104 мм. Сохрани **Ctrl+S**.

## Этап 6. Создать прозрачную гильзу

- **6.1.** В среде **Part** выбери **Part → Primitives → Tube**. Если откроется панель параметров, подтверди **OK** с исходными значениями. Переименуй объект в `Sleeve`.
- **6.2.** В **Data** задай выражения **в указанном порядке**, чтобы внутренний радиус не оказался больше наружного:

| Свойство | Выражение | Сейчас |
| --- | --- | --- |
| Outer Radius | `<<Parameters>>.SleeveOuterDiameter / 2` | 17,5 мм |
| Inner Radius | `<<Parameters>>.SleeveInnerDiameter / 2` | 14 мм |
| Height | `<<Parameters>>.SleeveLength` | 108 мм |

- **6.3.** Оставь **Placement** исходным: X=Y=Z=0, угол поворота 0°. Получится сквозная труба со стенкой **3,5 мм**.
- **6.4.** Выдели `Sleeve` → вкладка **View** внизу панели свойств → **Transparency = 80**. Батарея и блок плат должны быть видны внутри.
- **6.5.** Проверь вид сверху клавишей **2**, затем верни аксонометрию клавишей **0**. Оба макета должны помещаться внутри отверстия гильзы. **Ctrl+S**.

## Этап 7. Заготовка шасси с грибком

Пока это сплошная заготовка. Полости, контакты, петлю и уплотнительные канавки сделаем после проверки компоновки и размеров деталей.

- **7.1.** Выдели `Sleeve` в дереве → **Пробел**, чтобы временно скрыть. Аналогично скрой `Battery` и `Electronics`.
- **7.2.** **Part → Primitives → Cylinder** → имя `ChassisCore`. Выражения: **Radius** = `<<Parameters>>.ChassisDiameter / 2`, **Height** = `<<Parameters>>.SleeveLength`. Положение оставь нулевым. Получится Ø27,4 × 108 мм.
- **7.3.** Создай второй цилиндр → имя `RearFlange`. **Radius** = `<<Parameters>>.FlangeDiameter / 2`, **Height** = `<<Parameters>>.FlangeThickness`.
- **7.4.** У `RearFlange` в **Placement → Position → z** задай `-<<Parameters>>.FlangeThickness`. X=Y=0. Грибок занимает Z=−4…0 мм и касается основания `ChassisCore`.
- **7.5.** Удерживая **Ctrl**, выдели в дереве **только `ChassisCore` и `RearFlange`** → **Part → Boolean → Union**. Результат переименуй в `ChassisBlank`. Исходные цилиндры останутся внутри него в дереве, их размеры можно менять.
- **7.6.** У `ChassisBlank` установи **View → Transparency = 80**. Покажи `Sleeve`, `Battery` и `Electronics` через **Пробел**. Грибок должен быть с противоположной от блока плат стороны, снаружи гильзы. **Ctrl+S**.

Пересечение сплошного `ChassisBlank` с макетами на этом этапе ожидаемо: места под компоненты ещё не вырезаны. Передний фиксатор, шторка и петля пока не построены.

## Этап 8. Проверить связь размеров

- **8.1.** В `Parameters` временно измени **B3** с `65 mm` на `70 mm`.
- **8.2.** Проверь в **Data**: высота `Battery` — **70 мм**, координата z у `Electronics` — **85 мм**, высота `Sleeve` — **113 мм**. У заготовки шасси верх тоже должен подняться до Z=113 мм. Если модель не обновилась, нажми **F5**.
- **8.3.** Верни **B3 = `65 mm`**. Гильза снова должна иметь длину **108 мм**, платы — начинаться на Z=80 мм.
- **8.4.** Сохрани **Ctrl+S**. Результат: батарея, блок плат, гильза и заготовка шасси с грибком. Это компоновка, ещё не модель для печати.

Перед следующими вырезами нужны реальные размеры батареи, контактов и собранного комплекта плат. Для привода шторки также понадобится конкретный выключатель.

Если снизу мешает **Report view**, закрой панель её крестиком. Команду **Fit all** запускай при активном 3D-виде; из вкладки таблицы она может выдать `Unknown view command: ViewFit`.

## Этап 3. Цилиндр аккумулятора — выполнен

Это вспомогательный габарит для компоновки.

- **3.1.** Перейди с таблицы на вкладку 3D-вида документа. Выбери рабочую среду **Part**.
- **3.2.** Меню **Part → Primitives → Cylinder**. Выдели цилиндр в дереве, **F2** → `Battery`.
- **3.3.** В свойствах цилиндра, вкладка **Data**, дважды нажми значение **Radius**, затем клавишу **=**. В открывшемся редакторе введи `<<Parameters>>.BatteryDiameter / 2` → **OK**. Результат: **9 mm**.
- **3.4.** Аналогично для **Height**: редактор через **=**, выражение `<<Parameters>>.BatteryLength` → **OK**. Результат: **65 mm**.
- **3.5.** Щёлкни по 3D-виду. Нажми **0** (аксонометрия), затем **View → Standard views → Fit all** (показать всё). Сохрани **Ctrl+S**.

В редакторе выражений формулы вводятся **без начального `=`**: эта клавиша только открывает редактор. Если она не срабатывает, нажми значок выражения справа в поле свойства.
**Проверка этапа 3:** в дереве есть `Parameters` и `Battery`; цилиндр имеет диаметр **18 мм**, высоту **65 мм**. На этом этапе он начинается от Z=0; в шаге 5.1 переносим его на Z=10 мм.

## Этап 1. Документ — выполнен

- **1.1.** **Ctrl+N** — новый документ.
- **1.2.** Рабочая среда **Spreadsheet**.
- **1.3.** Меню **Spreadsheet → New Spreadsheet**.
- **1.4.** Выделить таблицу в дереве, **F2** → `Parameters`.
- **1.5.** **Ctrl+Shift+S** — сохранить как `xiao_wio_case.FCStd` в папке:

```text
D:\GitHub\Meshcore\Xiao&Wio_Case_FreeCad\designs\xiao_wio_case
```

## Этап 2. Параметры — выполнен

- **2.1.** Открыть `Parameters` двойным нажатием в дереве.
- **2.2.** Ввести значения с латинскими единицами `mm`:

| Строка | Столбец A | Столбец B |
| --- | --- | --- |
| 1 | Параметр | Значение |
| 2 | Диаметр аккумулятора | `18 mm` |
| 3 | Длина аккумулятора | `65 mm` |
| 4 | Радиус аккумулятора | `=BatteryDiameter / 2` |

- **2.3.** ПКМ на **B2 → Properties… → Alias** → `BatteryDiameter` → **OK**.
- **2.4.** Для **B3** задать alias `BatteryLength`.
- **2.5.** Формула в B4 должна дать **9 mm**. Сохранить **Ctrl+S**.

Имена относятся к ячейкам **B2/B3**. Текст в столбце C — необязательная памятка, не назначение alias.

## Принятые решения по конструкции

- Электроника: XIAO nRF52840 + Wio-SX1262 Kit.
- Аккумулятор: 18650. Контакты: отдельные металлические пластины, одна с пружиной, как у держателей AA.
- Наружный корпус: гладкая цилиндрическая гильза. Резьбовое соединение корпуса не используем.
- Шасси вставляется платами и торцом USB-C вперёд. Этот торец доходит до противоположного конца гильзы; антенный конец входит последним.
- На антенном конце шасси находится расширение в виде «грибка», ограничивающее дальнейшее продвижение к USB-C.
- Ушко для шнура — скруглённая проушина на заднем торце, смещена вверх от антенного разъёма.
- Снаружи гладкий цилиндр Ø35 мм без ступеней, виден только шов у грибка.
- Между шасси и гильзой одно резиновое кольцо 29 × 1,5 мм у грибка.
- Шасси держится в гильзе винтовым байонетом: три широких выступа, поворот 40° с затяжкой. Сплошную резьбу не используем: она съедает стенку 1,5 мм.
- Целевая защита — от брызг. Погружение в воду не является требованием.
- Выключателя нет: вставленная батарея сразу питает устройство.
- USB-C закрывает диск, утопленный в торец гильзы: открыто и закрыто, поворот на 180°.
- Контакты батареи приклеиваются к плоским стенкам, ушки выходят вниз в сквозные колодцы.
- Блок плат прижат печатной вставкой `BoardClamp`, снаружи кнопки и светодиоды не выводим.
- Материал: PETG, сопло 0,4 мм. Зазоры 0,3 мм на сторону сохраняем.
- Батарея смещена вверх (+Y) к окну шасси, под ней проходит паз для проводов батареи и антенны.

## Что ещё нужно определить

- Усилие пружины при принятой рабочей высоте 4 мм, направление ушек и геометрию фиксаторов контактов. Измеренные размеры батареи, плат и контактов записаны в этапе 9.

## Справка

[Spreadsheet](https://github.com/FreeCAD/FreeCAD-documentation/blob/main/wiki/Spreadsheet_Workbench.md) · [Cylinder](https://github.com/FreeCAD/FreeCAD-documentation/blob/main/wiki/Part_Cylinder.md) · [Cube](https://github.com/FreeCAD/FreeCAD-documentation/blob/main/wiki/Part_Box.md) · [Tube](https://github.com/FreeCAD/FreeCAD-documentation/blob/main/wiki/Part_Tube.md) · [Union](https://github.com/FreeCAD/FreeCAD-documentation/blob/main/wiki/Part_Fuse.md) · [Cut](https://github.com/FreeCAD/FreeCAD-documentation/blob/main/wiki/Part_Cut.md) · [Check geometry](https://github.com/FreeCAD/FreeCAD-documentation/blob/main/wiki/Part_CheckGeometry.md) · [Placement](https://github.com/FreeCAD/FreeCAD-documentation/blob/main/wiki/Placement.md) · [Expressions](https://github.com/FreeCAD/FreeCAD-documentation/blob/main/wiki/Expressions.md).
