ssserghei/xiao-wio-18650-tube-case/(commit log)

2026-11-07 Add XIAO + Wio-SX1262 18650 tube case v2
    FreeCAD 1.1.3 model, print-oriented STL files, renders, build and
    check scripts, design log and README. Licensed CC BY-SA 4.0; the board
    stack reference model by zuberio is CC0.
    [xiao-nrf52840-and-wio-sx1262.stl, xiao_wio_18650_tube_case.FCStd, xiao_wio_18650_tube_case_board_clamp.stl, xiao_wio_18650_tube_case_chassis.stl, xiao_wio_18650_tube_case_shutter.stl, xiao_wio_18650_tube_case_sleeve.stl]
2026-11-08 Apply post-print fixes: antenna seat, hex pocket, wire niche
    - 2 mm wall between the SMA jack flange and its nut
    - outer recess sized for a snug antenna base (9.56 mm measured)
    - 1 mm hex pocket so the jack cannot turn while the nut is tightened
    - full-width wire niche under the battery
    STL files are not re-exported yet.
    [xiao_wio_18650_tube_case.FCStd]
2026-11-08 Add first prototype photos to the README
    Photos are resized to 1400 px and stripped of metadata; the originals
    stay local and are ignored.
2026-11-08 Drop the O-ring, chunkier bayonet, walls for the wire niche
    - O-ring groove removed: printed PETG is porous, the seal was illusory
    - bayonet lugs 2.4 mm thick and 45 degrees wide with 0.2-0.25 mm
    clearance, using the rear wall freed by the groove
    - wire niche closed by a 1.5 mm outer wall so wires stay in while the
    sleeve goes on
    [xiao_wio_18650_tube_case.FCStd]
2026-11-08 Widen the pin slots to 2.75 mm for Dupont housings
    [xiao_wio_18650_tube_case.FCStd]
2026-11-09 Add diamond knurl bands at both ends of the sleeve
    [xiao_wio_18650_tube_case.FCStd]
2026-11-09 Replace the knurl with a raised diamond rib lattice
    [xiao_wio_18650_tube_case.FCStd]
2026-11-09 Add reverse-battery guard, marks, coarse rounded lattice, standing print
    - Plus plate sits 0.5 mm behind a guard ring with a 10 mm hole; a reversed
    cell rests its flat end on the ring.
    - Compartment moves 0.5 mm away from the minus plate: spring gap 2.5 mm.
    - Finger scoop at the plus end of the battery window.
    - Engraved polarity signs; lock and insert grooves on the flange, a line on
    the sleeve.
    - Rib lattice: 6 diamonds around, rounded corners, 30 degree walls, whole
    cells only.
    - 45 degree cone under the flange with a matching sleeve skirt, so the
    chassis prints standing on its USB end.
    - scripts/rebuild_static.py rebuilds the bayonet, lattice, cable, marks and
    rear fillets from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
    [xiao_wio_18650_tube_case.FCStd]
2026-11-09 Open the plus window again, enlarge the shutter detents
    - The guard ring left a 0.4 mm slot behind it that cannot be printed. The
    plate-sized window in front of the plus plate is open again; the pocket
    wall beside the window stops a reversed cell 0.5 mm short of the plate.
    - Shutter detents: sleeve notches 0.75 mm deep and 3 mm wide, disc ribs
    0.35 mm proud, spring slot 0.6 mm, so a 0.4 mm nozzle prints them.
    - rebuild_static.py: front crest fillet re-pick split out.
    Checked with check_stage_29_32.py (FINAL_CHECK passed).
    [xiao_wio_18650_tube_case.FCStd]
2026-11-10 Size the plus recess to the measured battery, move the front wall onto the boards
    - The pocket ends at the cell's shoulder; the plate bump sits where the measured 1.32 mm button arrives, 1.02 mm behind the pocket end. The minus spring keeps 2.5 mm. New dummy BatteryButton.
    - The front wall stands 0.15 mm from the PCBs and the USB-C connector passes through its window: case 1.5 mm shorter (131.9 mm), the plug reaches 1.5 mm deeper. New dummy USBConnector; invalid board meshes are boxed in two parts in the check.
    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
    [xiao_wio_18650_tube_case.FCStd]
2026-11-10 Export STL for print 3: chassis standing on its USB end
    All four meshes re-exported from the current model and checked manifold. The chassis is now oriented standing on the USB-C end (no supports, 8 mm brim); sliced with the Ender-3 / 0.20 mm NORMAL / Generic PETG profiles: chassis 4 h 18 min 32 g, sleeve 4 h 12 min 29 g (rear seam), clamp 17 min, disc 14 min. README and TODO updated.
    [xiao_wio_18650_tube_case_board_clamp.stl, xiao_wio_18650_tube_case_chassis.stl, xiao_wio_18650_tube_case_shutter.stl, xiao_wio_18650_tube_case_sleeve.stl]
2026-11-11 Thinner sleeve: 0.9 mm in the cells, Ø35.4 over the ribs
    The print-3 sleeve was far too stiff. SleeveOuterDiameter 35 -> 33.8; ribs stay 0.8 mm, flange follows, rear fillets re-picked. The rib shell overlaps the wall by 0.1 mm only so it no longer refills the bayonet grooves and shutter notches. STL re-exported; README gives slicer settings against the stringing web inside the tube. Checked with check_stage_29_32.py (FINAL_CHECK passed).
    [xiao_wio_18650_tube_case.FCStd, xiao_wio_18650_tube_case_chassis.stl, xiao_wio_18650_tube_case_sleeve.stl]
2026-11-12 Add photos of the second prototype
    Resized copies without metadata; the phone originals stay local and ignored.
